DhaDylan/esp32c3-direction-finding/renders/pcb_bottom.png

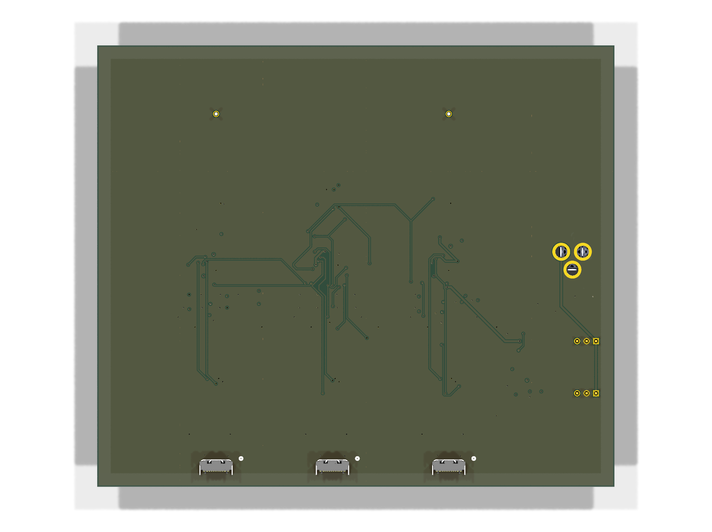
renders/pcb_bottom.png
