DhaDylan/esp32c3-direction-finding/renders/pcb_iso.png

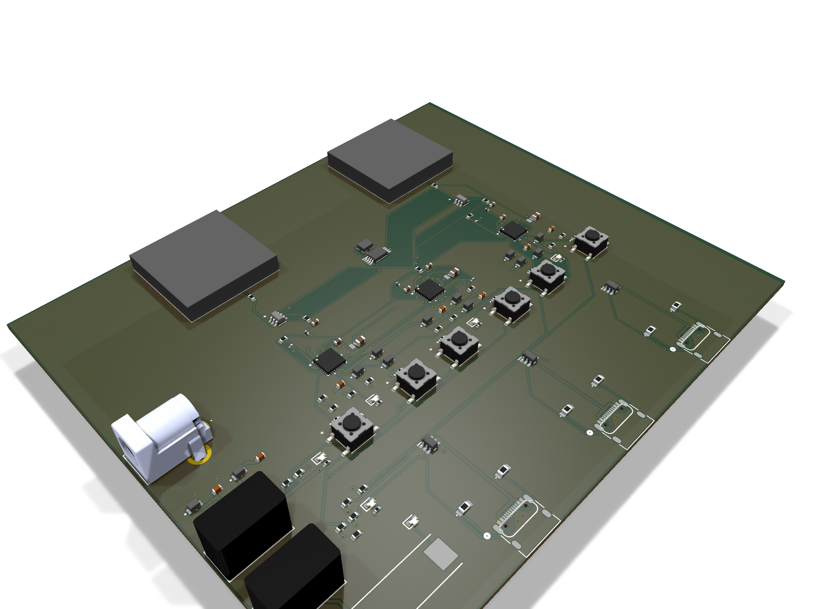
renders/pcb_iso.png
