DhaDylan/esp32c3-direction-finding/renders/pcb_top.png

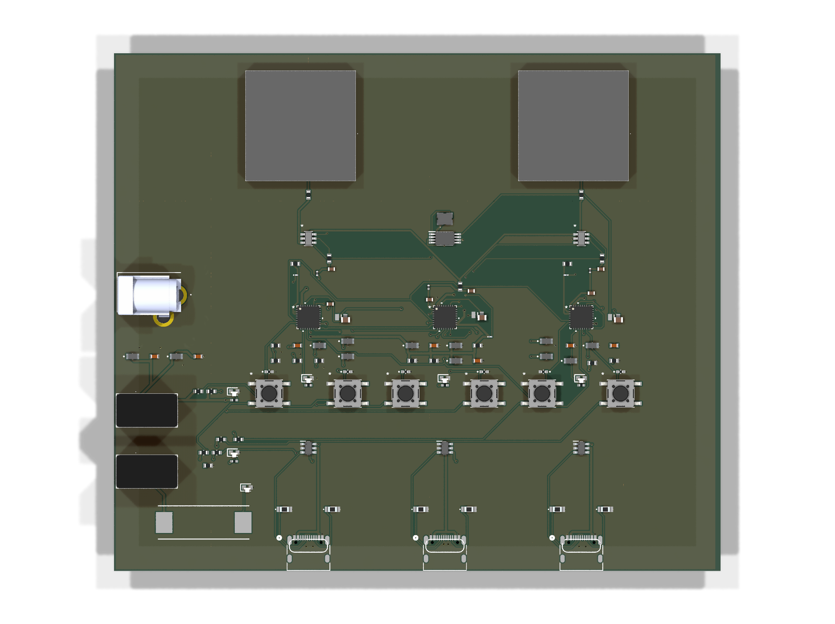
renders/pcb_top.png
