DhaDylan/esp32c3-direction-finding/renders/proto2x4_iso.png

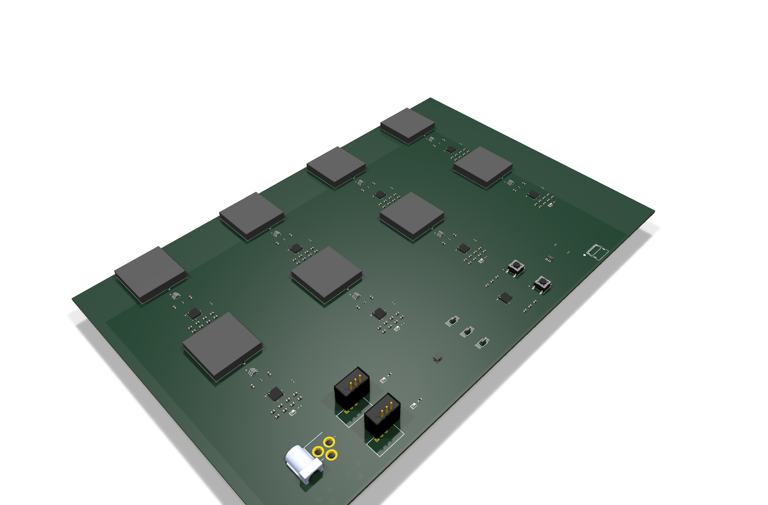
renders/proto2x4_iso.png
