DhaDylan/esp32c3-direction-finding/renders/proto2x4_top.png

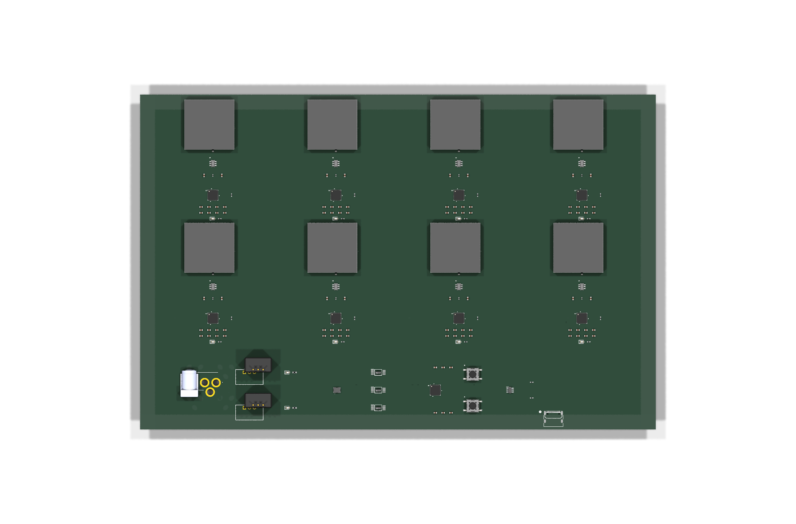
renders/proto2x4_top.png
