DhaDylan/esp32c3-direction-finding/3dmodels/3dmodels/generic_R_0402_1005Metric.stp

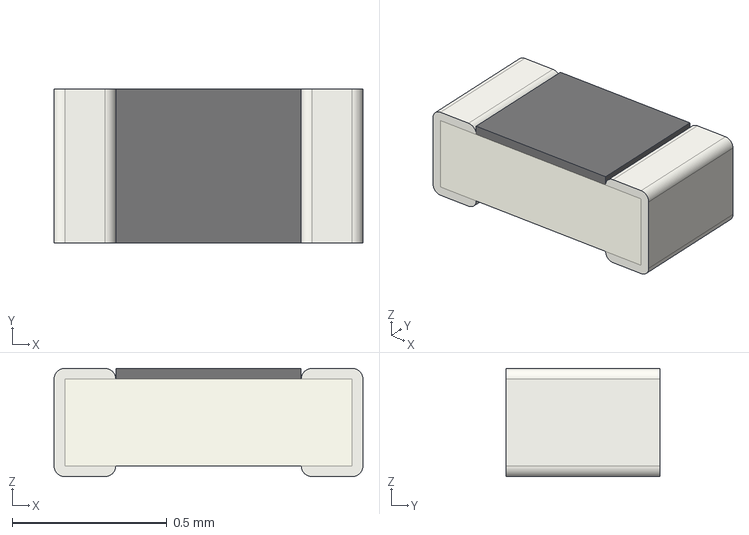
[picture p7: CAD file, 2026-08-13]
3dmodels/3dmodels/generic_R_0402_1005Metric.stp
1.00 x 0.5 x 0.35 mm
