DhaDylan/esp32c3-direction-finding/3dmodels/3dmodels/MHQ0402PSA2N0ST000.stp

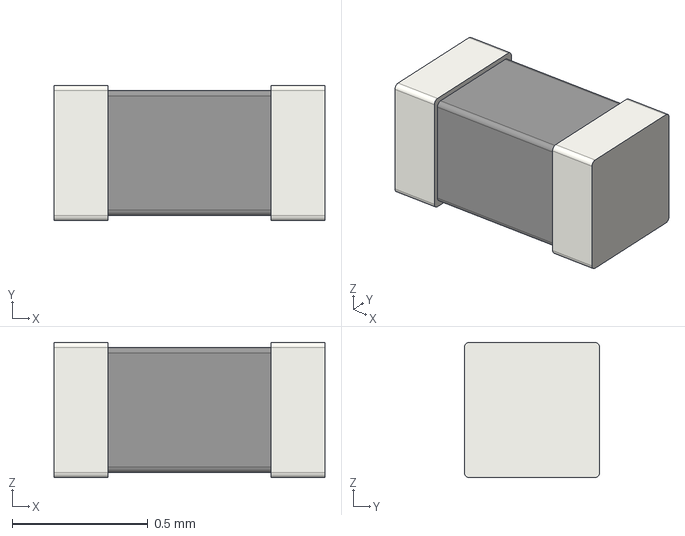
[picture p8: CAD file, 2026-08-13]
3dmodels/3dmodels/MHQ0402PSA2N0ST000.stp
1.00 x 0.5 x 0.5 mm
