DhaDylan/esp32c3-direction-finding/3dmodels/3dmodels/generic_SW_PTS645.stp

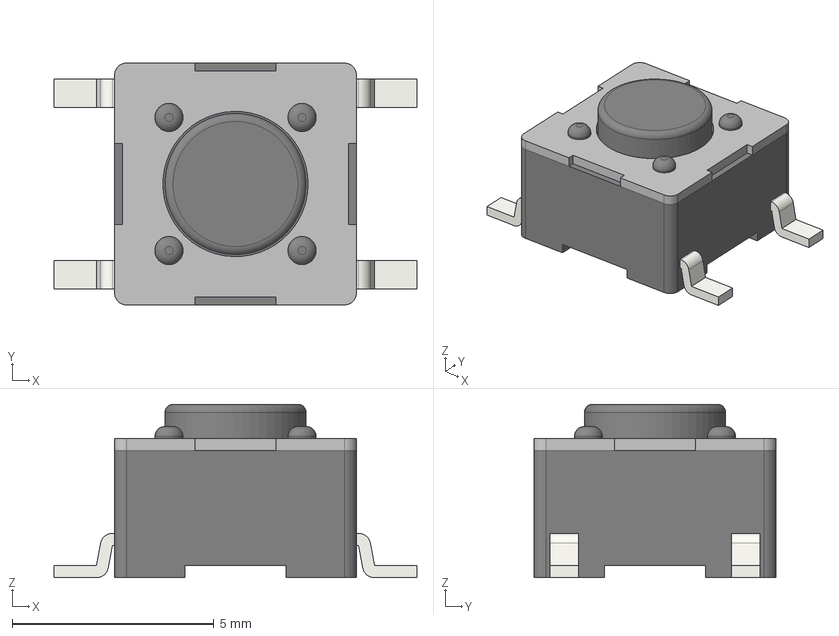
[picture p9: CAD file, 2026-08-13]
3dmodels/3dmodels/generic_SW_PTS645.stp
9.00 x 6.00 x 4.30 mm
