DhaDylan/esp32c3-direction-finding/3dmodels/3dmodels/generic_C_0603_1608Metric.stp

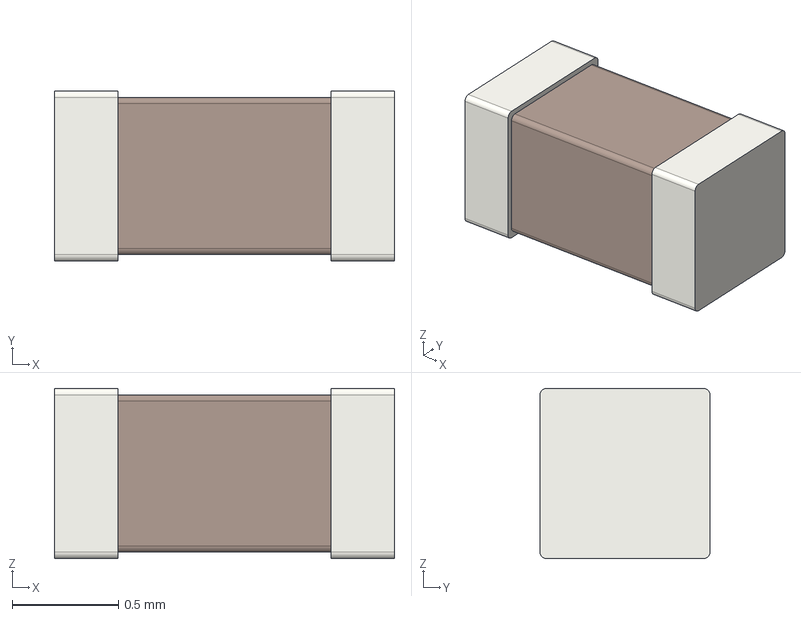
[picture p10: CAD file, 2026-08-13]
3dmodels/3dmodels/generic_C_0603_1608Metric.stp
1.60 x 0.8 x 0.8 mm
