DhaDylan/esp32c3-direction-finding/3dmodels/3dmodels/generic_QFN32_5x5mm.stp

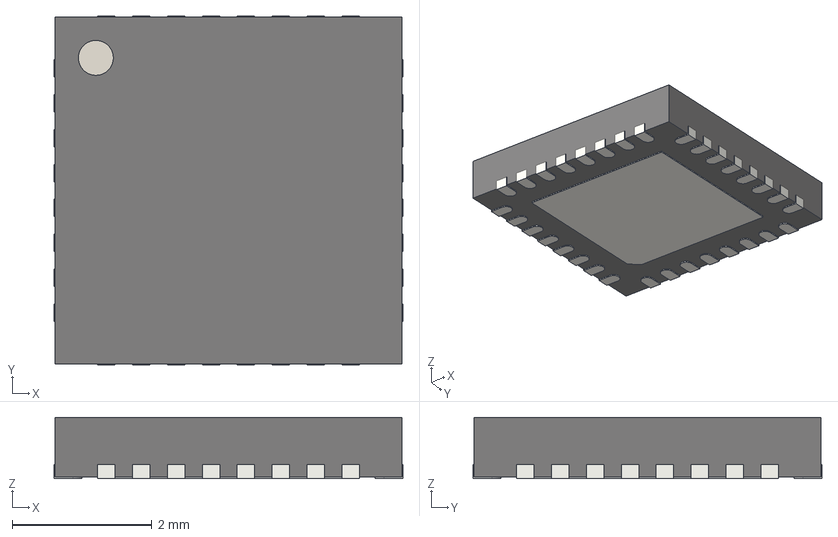
[picture p11: CAD file, 2026-08-13]
3dmodels/3dmodels/generic_QFN32_5x5mm.stp
5.00 x 5.00 x 0.875 mm
