DhaDylan/esp32c3-direction-finding/3dmodels/3dmodels/LTST-C190GKT.stp

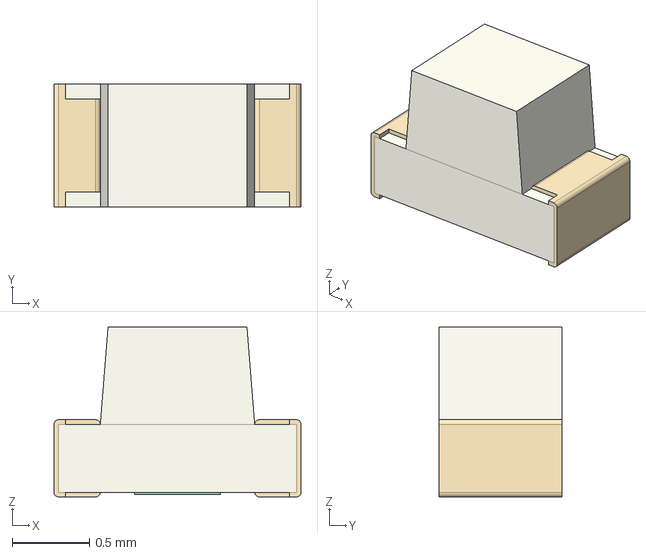
[picture p12: CAD file, 2026-08-13]
3dmodels/3dmodels/LTST-C190GKT.stp
1.60 x 0.8 x 1.10 mm
