DhaDylan/esp32c3-direction-finding/3dmodels/3dmodels/LM2936M-3.3_NOPB.stp

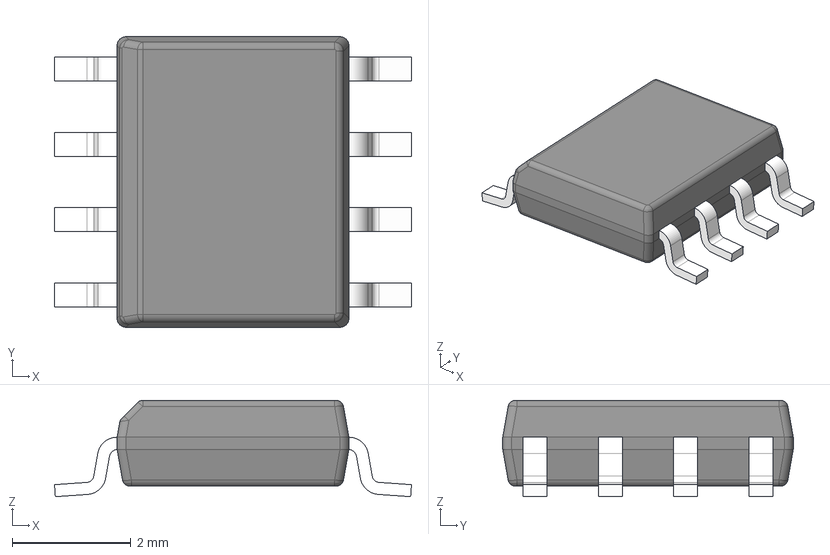
[picture p13: CAD file, 2026-08-12]
3dmodels/3dmodels/LM2936M-3.3_NOPB.stp
6.02 x 4.90 x 1.63 mm
BODY-SO
LEAD-D0008A x 8
