DhaDylan/esp32c3-direction-finding/3dmodels/3dmodels/USB4105-GF-A.stp

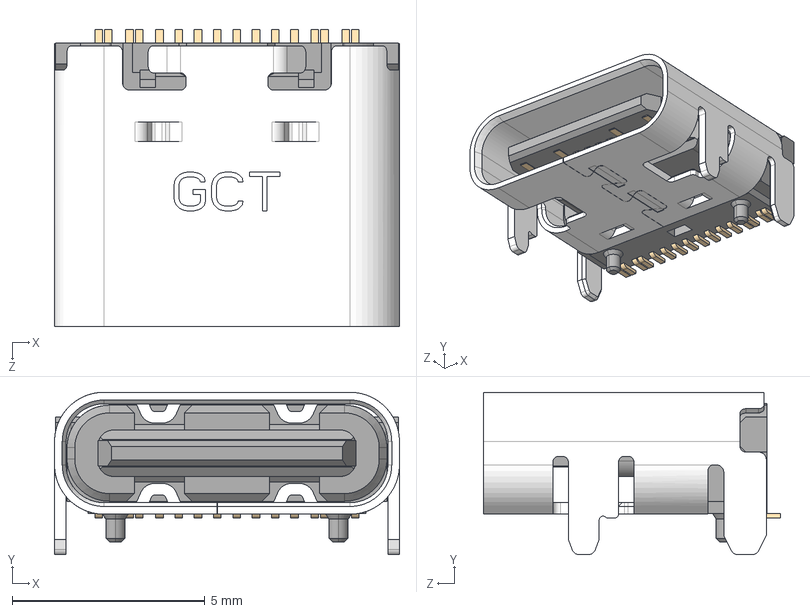
[picture p14: CAD file, 2026-08-12]
3dmodels/3dmodels/USB4105-GF-A.stp
8.94 x 4.21 x 7.70 mm
HSG_默认
