DhaDylan/esp32c3-direction-finding/3dmodels/3dmodels/ERJ-UP6D5101V.stp

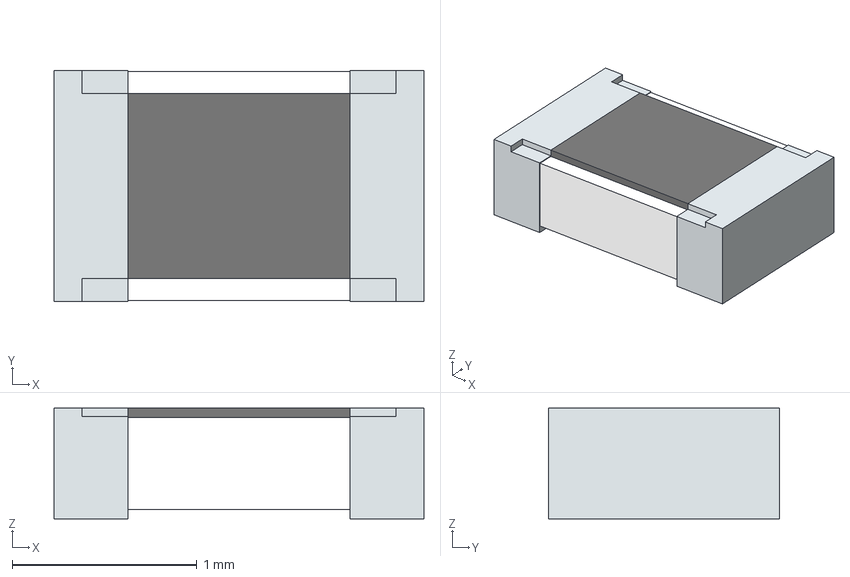
[picture p15: CAD file, 2026-08-12]
3dmodels/3dmodels/ERJ-UP6D5101V.stp
2.00 x 1.25 x 0.6 mm
solidBody
Terminal
solidTop
