DhaDylan/esp32c3-direction-finding/3dmodels/3dmodels/CGA3E3X7R1H105K080AB.stp

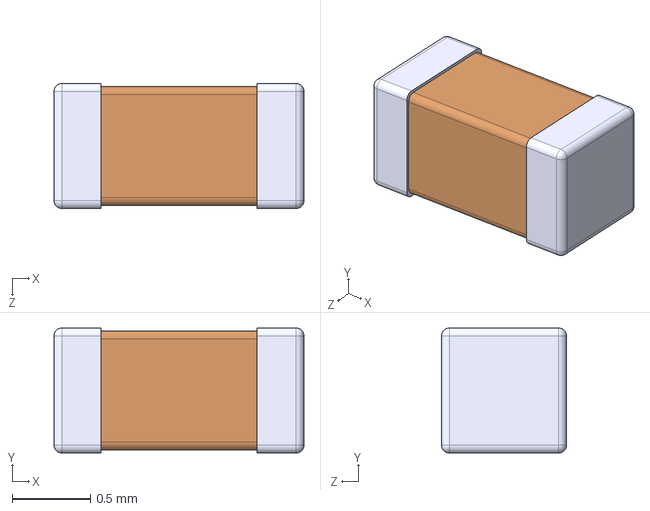
[picture p16: CAD file, 2026-08-12]
3dmodels/3dmodels/CGA3E3X7R1H105K080AB.stp
1.60 x 0.8 x 0.8 mm
