DhaDylan/esp32c3-direction-finding/3dmodels/3dmodels/0603YC103M4T2A.stp

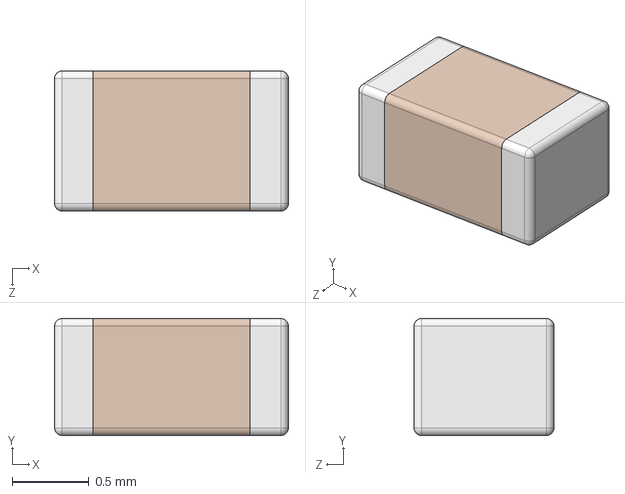
[picture p17: CAD file, 2026-08-12]
3dmodels/3dmodels/0603YC103M4T2A.stp
1.52 x 0.76 x 0.91 mm
