DhaDylan/esp32c3-direction-finding/3dmodels/3dmodels/RJ-6_ADI.step

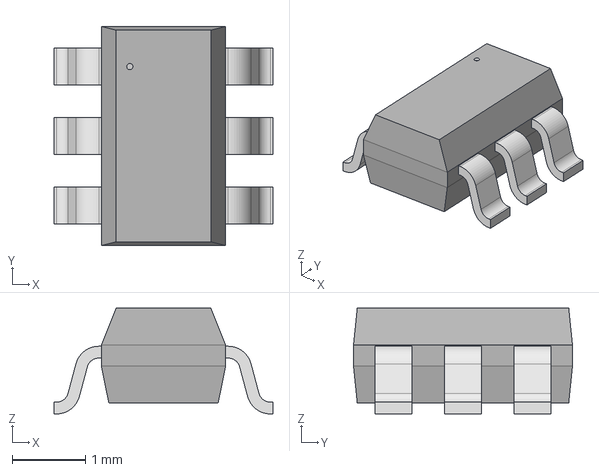
[picture p18: CAD file, 2026-08-12]
3dmodels/3dmodels/RJ-6_ADI.step
3.00 x 3.00 x 1.45 mm
