DhaDylan/esp32c3-direction-finding/3dmodels/3dmodels/USBLC6-2SC6.stp

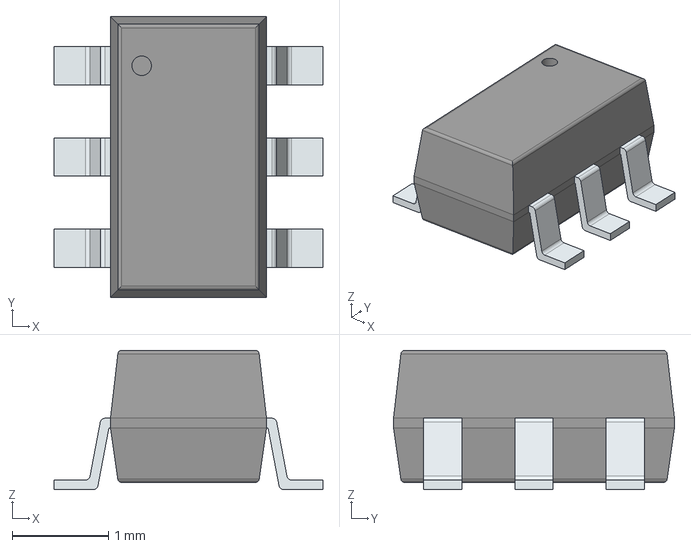
[picture p19: CAD file, 2026-08-12]
3dmodels/3dmodels/USBLC6-2SC6.stp
2.80 x 2.92 x 1.45 mm
PinsArrayLR
