DhaDylan/esp32c3-direction-finding/3dmodels/3dmodels/WDP.2458.25.4.B.02.stp

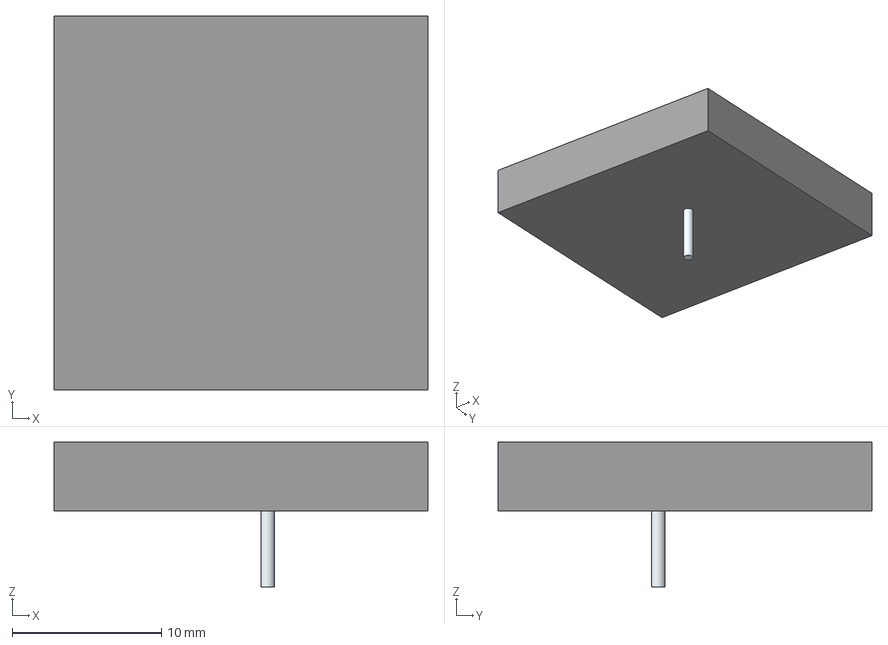
[picture p20: CAD file, 2026-08-12]
3dmodels/3dmodels/WDP.2458.25.4.B.02.stp
25.1 x 25.1 x 9.70 mm
Leads
