DhaDylan/esp32c3-direction-finding/3dmodels/3dmodels/TSR_2-2433N.stp

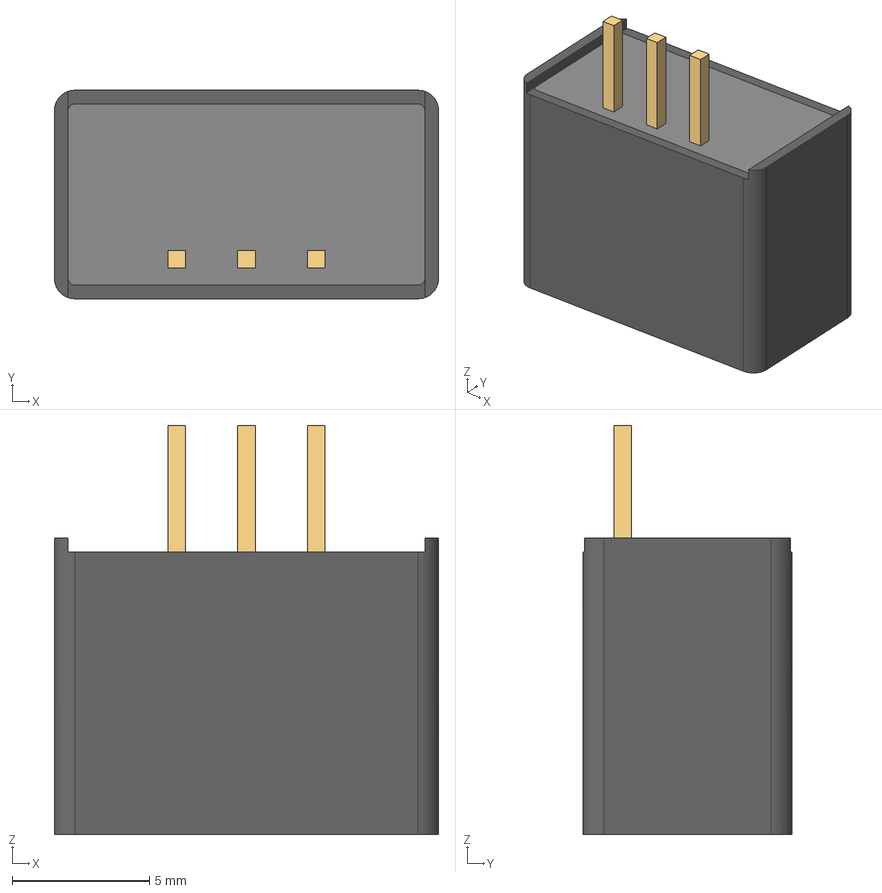
[picture p21: CAD file, 2026-08-12]
3dmodels/3dmodels/TSR_2-2433N.stp
14.0 x 7.60 x 14.9 mm
CASE-00
膠-00
PIN-00 x 3
