DhaDylan/esp32c3-direction-finding/3dmodels/3dmodels/ECE-A1CN100U.stp

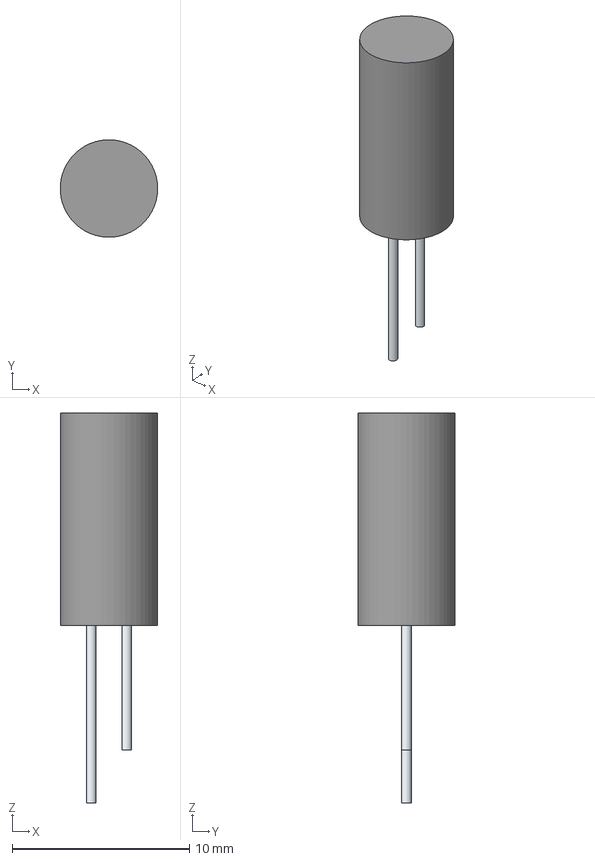
[picture p22: CAD file, 2026-08-12]
3dmodels/3dmodels/ECE-A1CN100U.stp
5.49 x 5.50 x 22.0 mm
SimpleBody
Pin1
Pin2
