DhaDylan/esp32c3-direction-finding/3dmodels/3dmodels/CDCLVC1103PW.stp

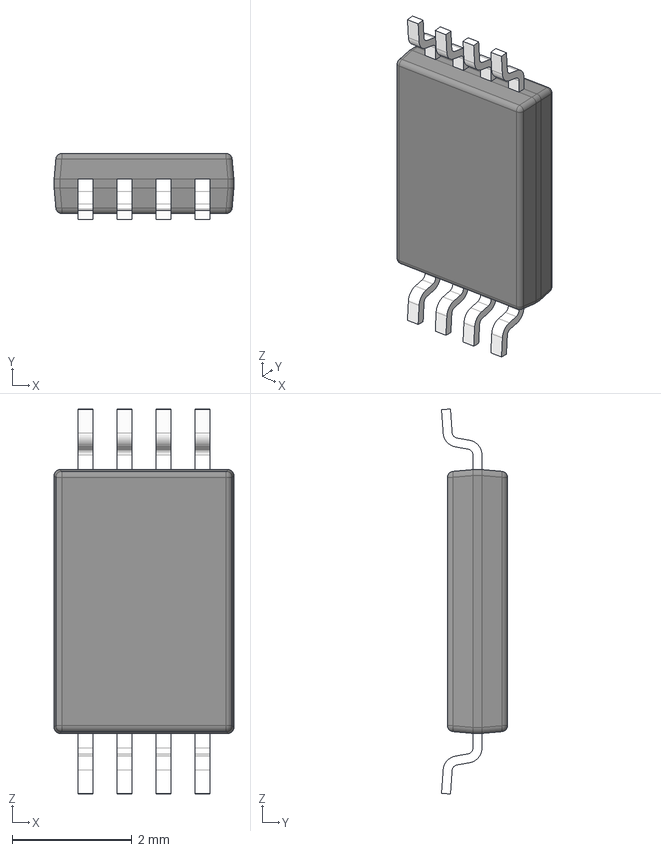
[picture p23: CAD file, 2026-08-12]
3dmodels/3dmodels/CDCLVC1103PW.stp
3.00 x 1.10 x 6.42 mm
BODY-SO
LEAD-SO x 8
PIN1-ID
