DhaDylan/esp32c3-direction-finding/3dmodels/3dmodels/MLG0603S2N0ST000.stp

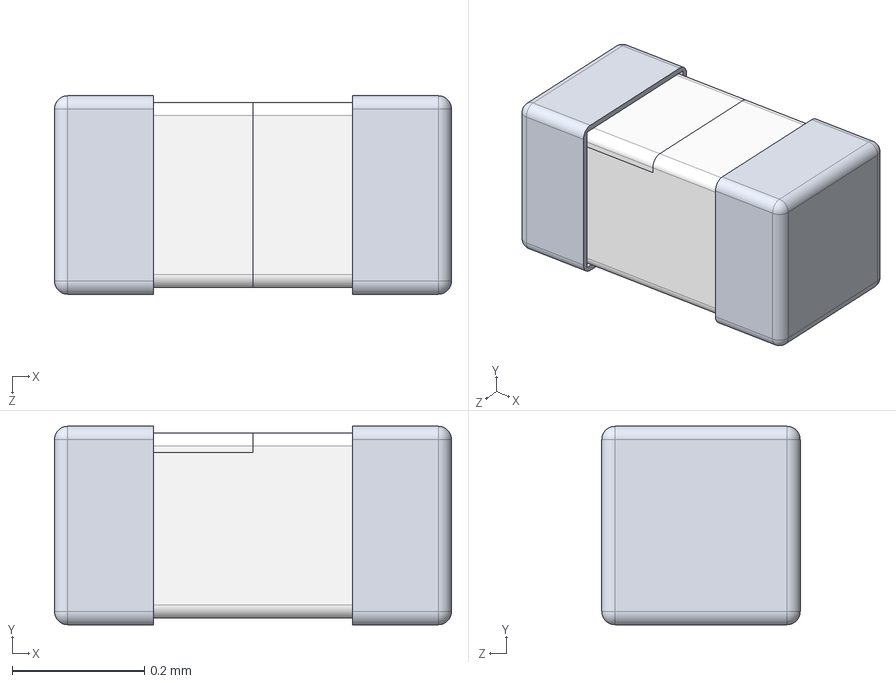
[picture p24: CAD file, 2026-08-12]
3dmodels/3dmodels/MLG0603S2N0ST000.stp
0.6 x 0.3 x 0.3 mm
