DhaDylan/esp32c3-direction-finding/3dmodels/3dmodels/RCLAMP0524S.TCT.stp

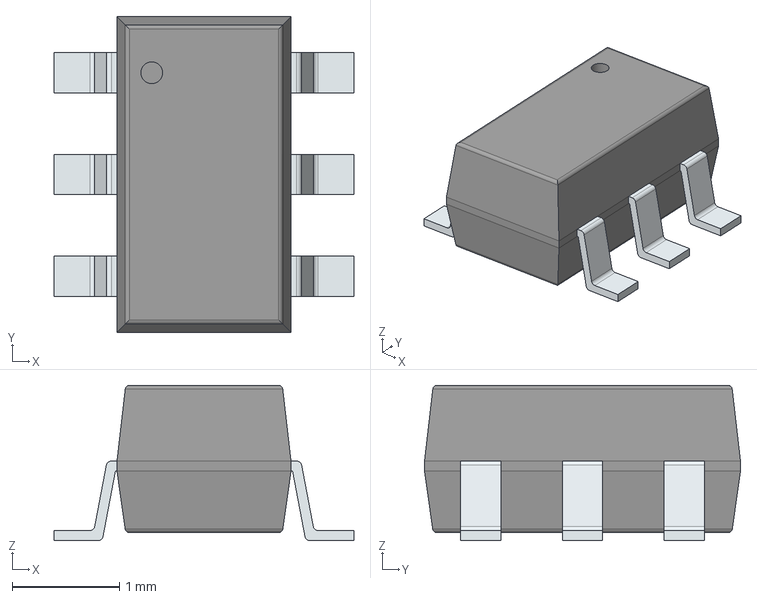
[picture p25: CAD file, 2026-08-12]
3dmodels/3dmodels/RCLAMP0524S.TCT.stp
2.80 x 2.95 x 1.45 mm
PinsArrayLR
