DhaDylan/esp32c3-direction-finding/3dmodels/3dmodels/MP2307DN-LF-Z.stp

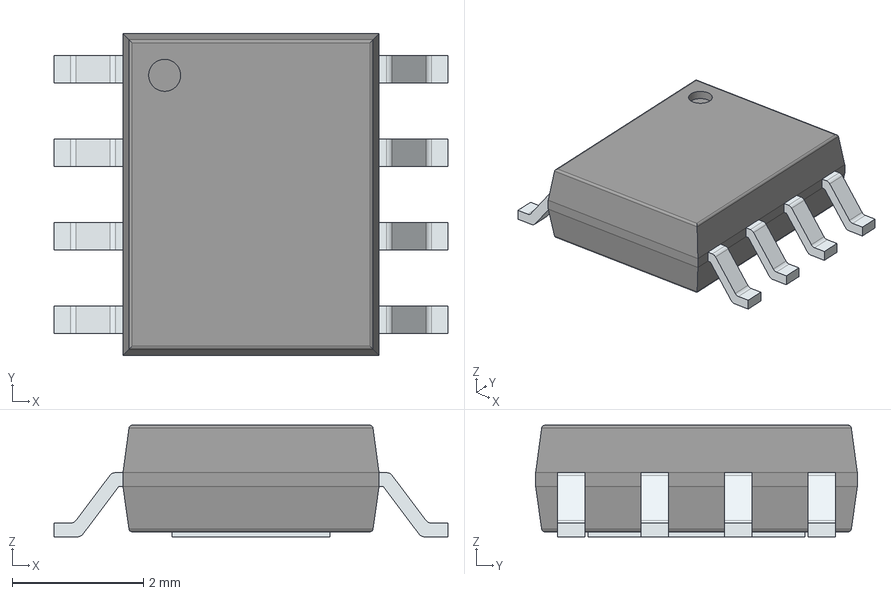
[picture p26: CAD file, 2026-08-12]
3dmodels/3dmodels/MP2307DN-LF-Z.stp
6.00 x 4.90 x 1.70 mm
PinsArrayLR
ThermalPad
