DhaDylan/esp32c3-direction-finding/3dmodels/3dmodels/LT1763IDE-3.3#PBF.stp

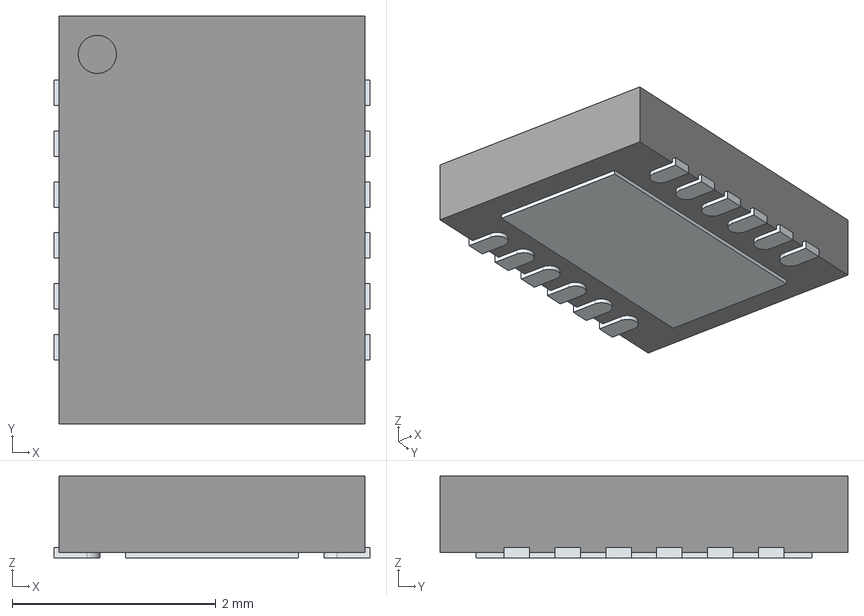
[picture p27: CAD file, 2026-08-12]
3dmodels/3dmodels/LT1763IDE-3.3#PBF.stp
3.10 x 4.00 x 0.8 mm
ThermalPin
PinsArrayLR
