DhaDylan/esp32c3-direction-finding/3dmodels/3dmodels/C1608X7T1A106M080AC.stp

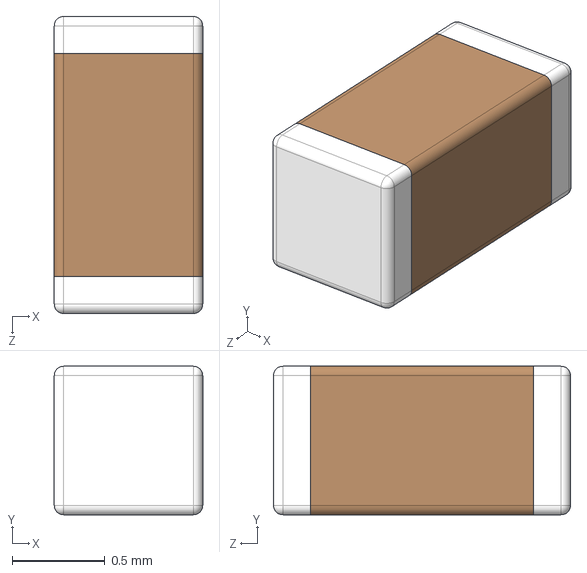
[picture p28: CAD file, 2026-08-12]
3dmodels/3dmodels/C1608X7T1A106M080AC.stp
0.8 x 0.8 x 1.60 mm
