DhaDylan/esp32c3-direction-finding/3dmodels/3dmodels/MBASQ21GAB7104MTCA01.stp

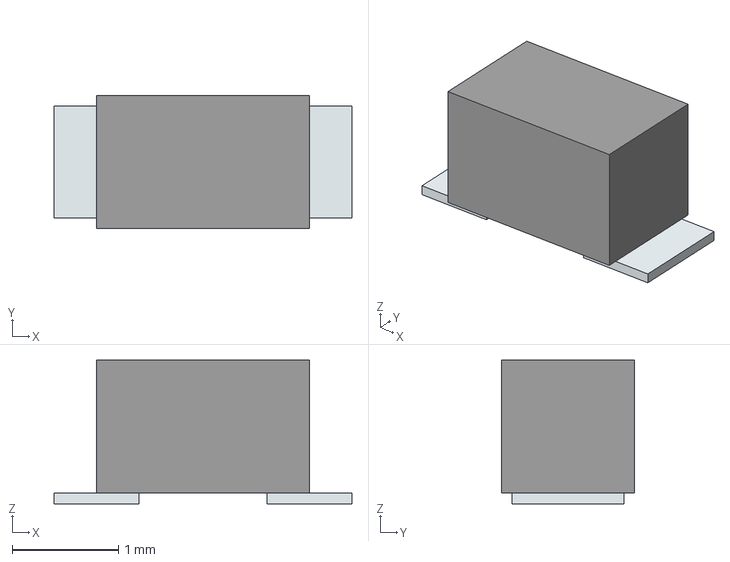
[picture p29: CAD file, 2026-08-12]
3dmodels/3dmodels/MBASQ21GAB7104MTCA01.stp
2.80 x 1.25 x 1.35 mm
Pins
