DhaDylan/esp32c3-direction-finding/3dmodels/3dmodels/ABM14N-40.0000MHZ-8-N1U.stp

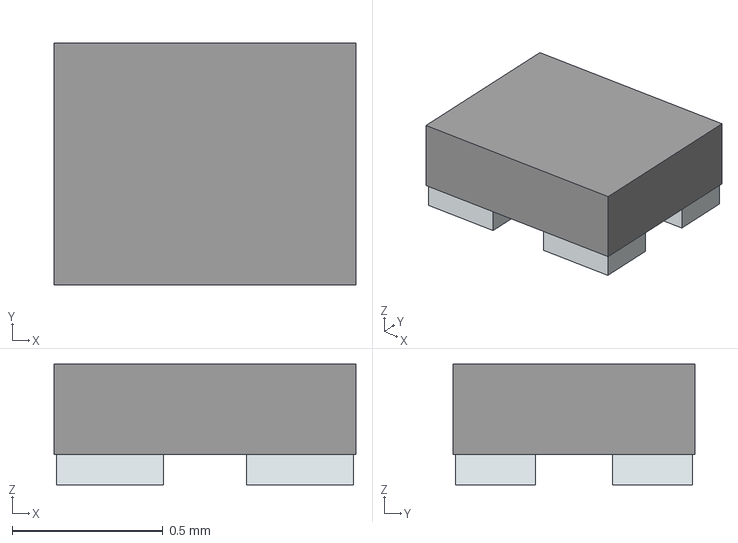
[picture p30: CAD file, 2026-08-12]
3dmodels/3dmodels/ABM14N-40.0000MHZ-8-N1U.stp
1.00 x 0.8 x 0.4 mm
Pins
