DhaDylan/esp32c3-direction-finding/3dmodels/3dmodels/MP2329CGG-Z.stp

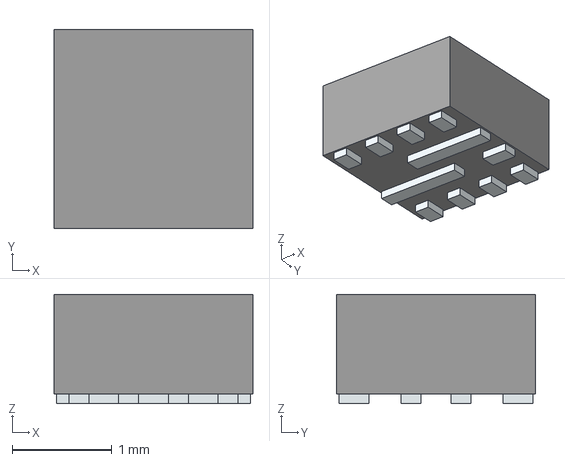
[picture p31: CAD file, 2026-08-12]
3dmodels/3dmodels/MP2329CGG-Z.stp
2.00 x 2.00 x 1.10 mm
Pins
