DhaDylan/esp32c3-direction-finding/(list of files, cad)

Other CAD files:
3dmodels/3dmodels/430182043816.stp
3dmodels/3dmodels/694106301002.stp
3dmodels/3dmodels/FK4000032.stp
3dmodels/3dmodels/MCU08050C2209FP500.stp
3dmodels/3dmodels/RCC04021K50FKED.stp
