DhaDylan/esp32c3-direction-finding/(list of files, drawings)

Other design files:
pcb/board.dsn
pcb/board_rs.dsn
pcb/board_sym2.dsn
pcb/board_v4.dsn
pcb/board_v4b.dsn
pcb/board_v5.dsn
