DhaDylan/esp32c3-direction-finding/pcb/10.28.25 V2 Wifi PCB.kicad_pcb

## KiCad design pcb/10.28.25 V2 Wifi PCB.kicad_pcb (2026-08-13)

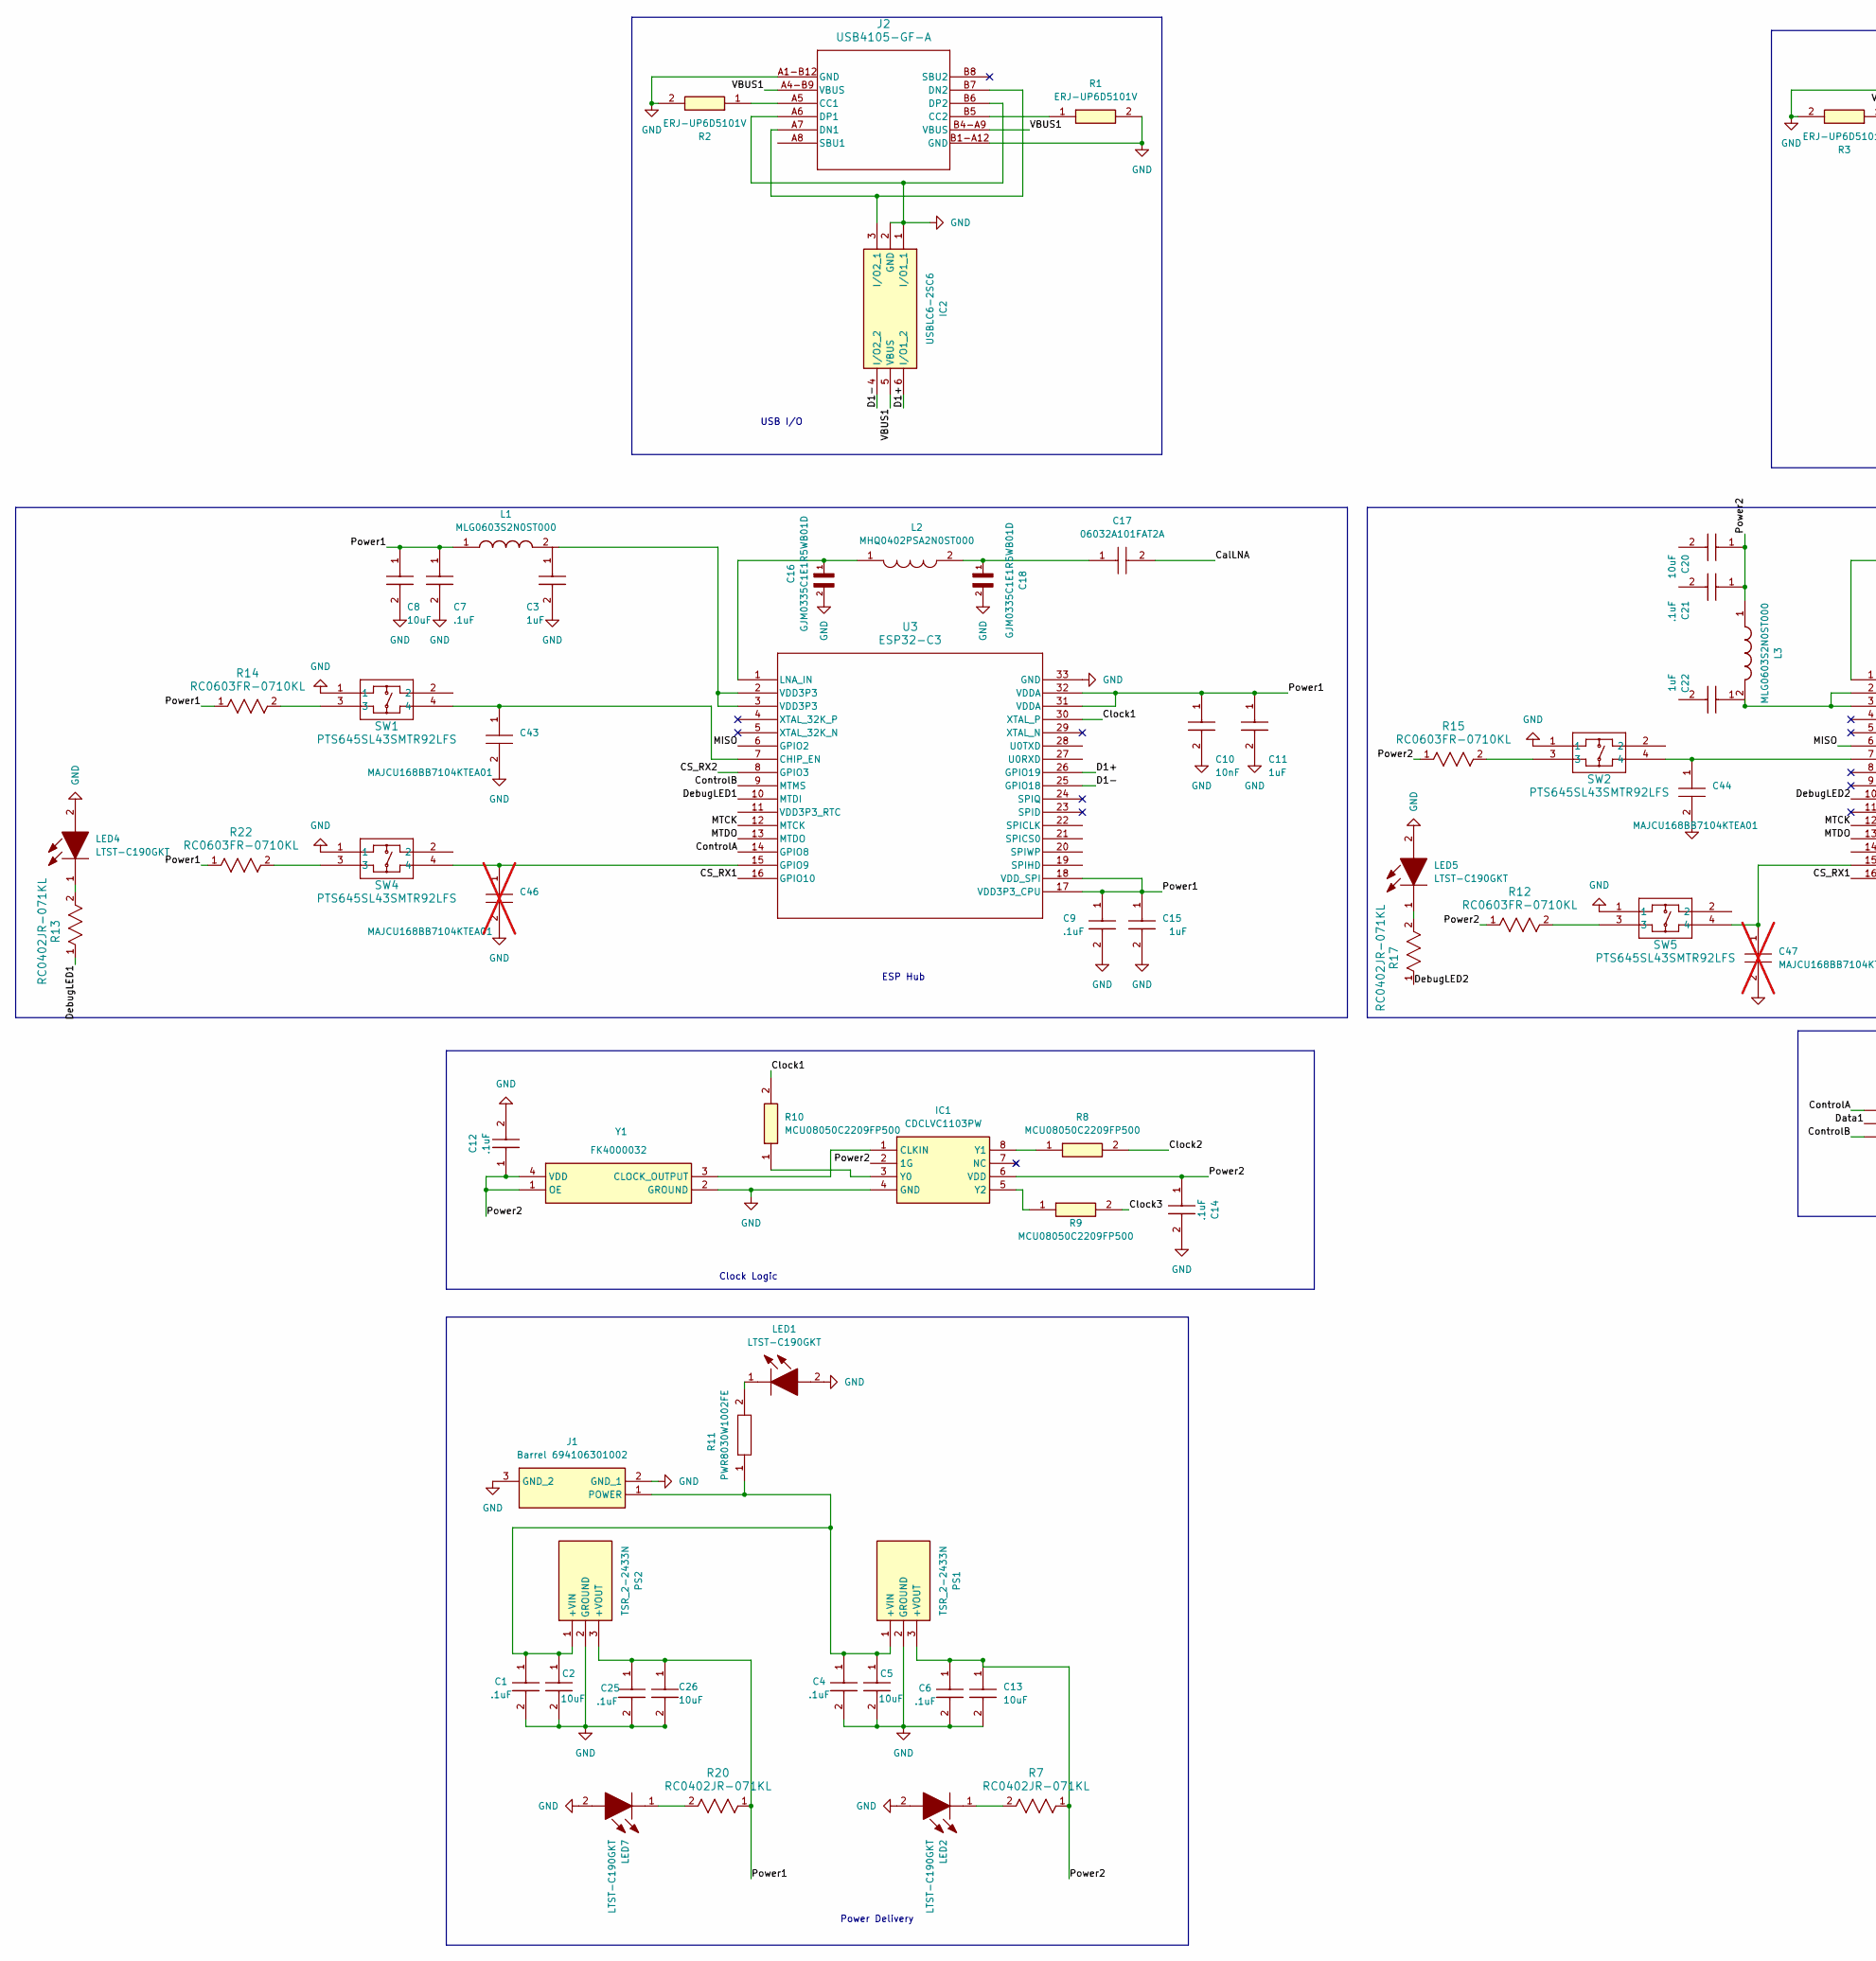
[picture p32: schematic 10.28.25 V2 Wifi PCB.kicad_sch, part in row 1, column 1]

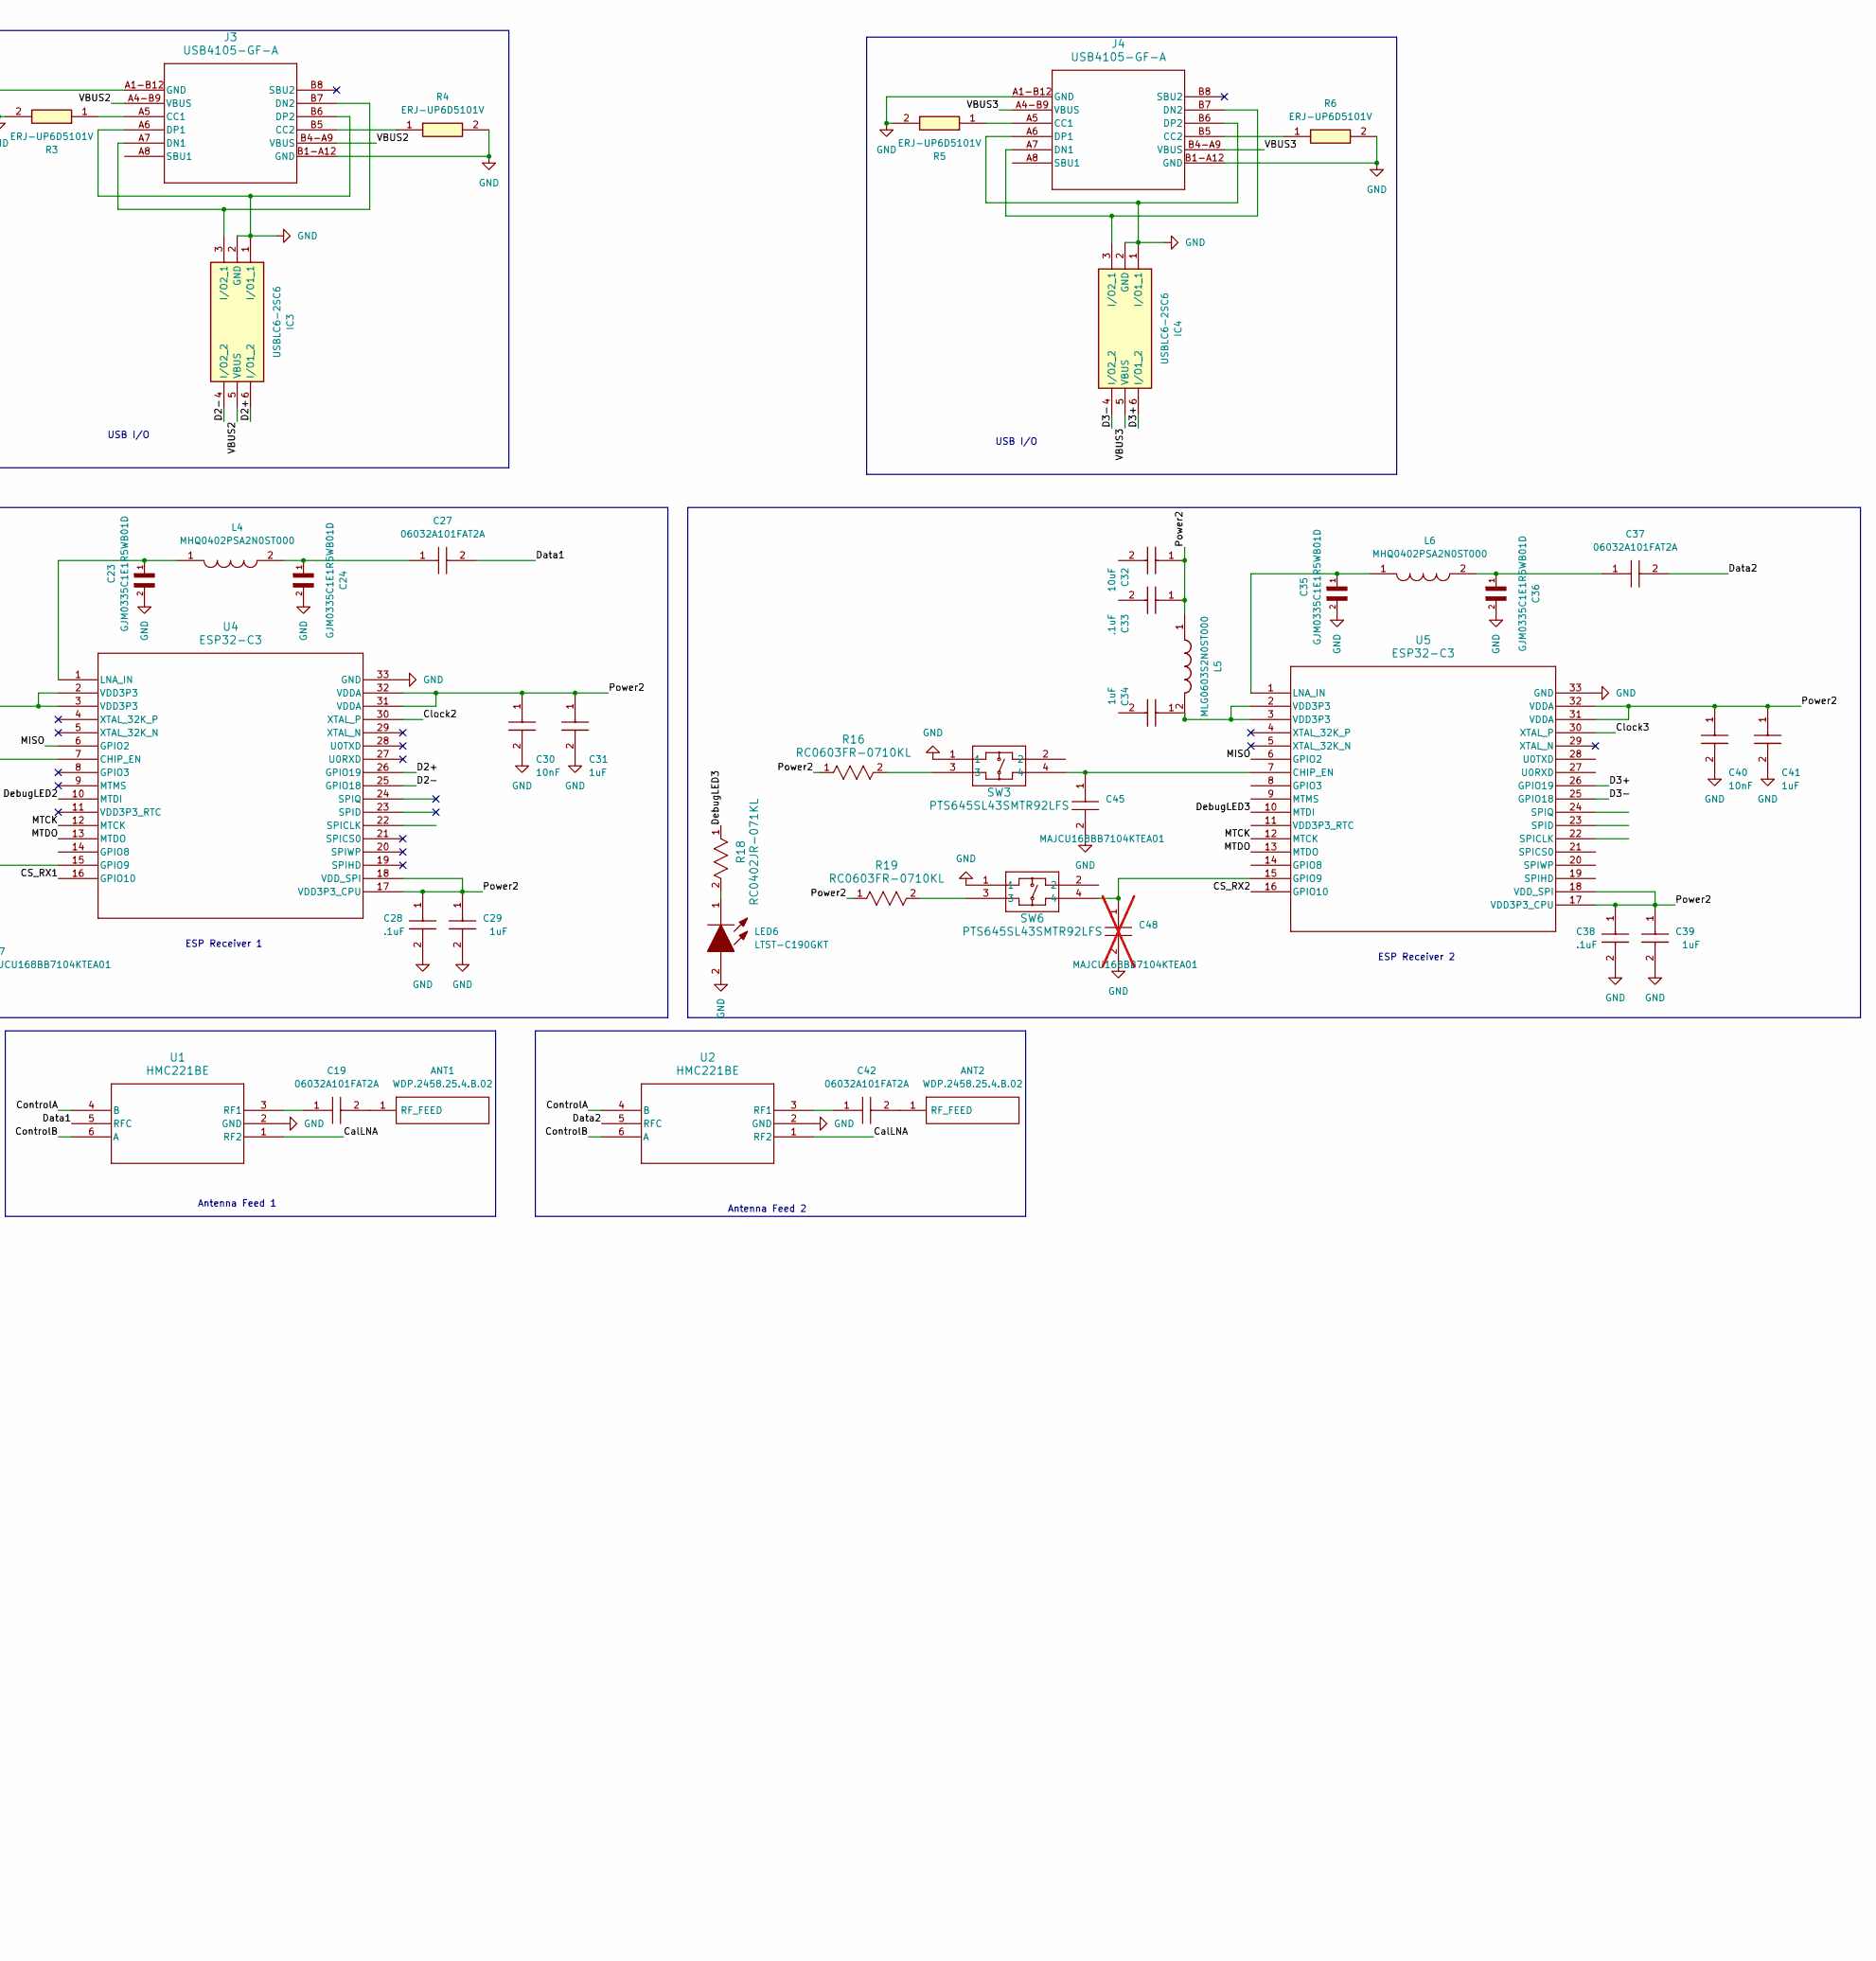
[picture p33: schematic 10.28.25 V2 Wifi PCB.kicad_sch, part in row 1, column 2]

Parts:
ANT1, ANT2: WDP.2458.25.4.B.02; WDP2458254B02; Mouser Part Number 960-WDP.2458.25.4B02
C1, C4, C6, C7, C9, C12, C14, C21, C25, C28, C33, C38: .1uF; MBASx21x; Manufacturer_Part_Number MBASQ21GAB7104MTCA01
C2, C5, C8, C13, C20, C26, C32: 10uF; CAPC1608X80N; Mouser Part Number 810-C1608X7T1A106M08
C3, C11, C15, C22, C29, C31, C34, C39, C41: 1uF; CAPC1608X90N; Manufacturer_Part_Number CGA3E3X7R1H105K080AB
C10, C30, C40: 10nF; CAPC1608X90N; Mouser Part Number 581-0603YC103M4T2A
C16, C18, C23, C24, C35, C36: GJM0335C1E1R5WB01D; CAPC0603X33N
C17, C19, C27, C37, C42: 06032A101FAT2A; CAPC1608X90N; Mouser Part Number 581-06032A101FAT2A
C43, C44, C45: MAJCU168BB7104KTEA01; MAJx16; Manufacturer_Part_Number MAJCU168BB7104KTEA01
C46, C47, C48: MAJCU168BB7104KTEA01; MAJx16; Manufacturer_Part_Number MAJCU168BB7104KTEA01; not fitted
IC1: CDCLVC1103PW; SOP65P640X120-8N; Mouser Part Number 595-CDCLVC1103PW
IC2, IC3, IC4: USBLC6-2SC6; SOT95P280X145-6N; Mouser Part Number 511-USBLC6-2SC6
J1: Barrel 694106301002; 694106301002_1; Mouser Part Number 710-694106301002
J2, J3, J4: USB4105-GF-A; USB4105_GCT
L1, L3, L5: MLG0603S2N0ST000; MLG0603S; Manufacturer_Part_Number MLG0603S2N0ST000
L2, L4, L6: MHQ0402PSA2N0ST000; INDC0402X26N; Mouser Part Number 810-MHQ0402PSA2N0ST0
LED1, LED2, LED4, LED5, LED6, LED7: LTST-C190GKT; LEDC1608X90N; Mouser Part Number 859-LTST-C190GKT
PS1, PS2: TSR_2-2433N; TSR22433N; Manufacturer_Part_Number TSR 2-2433N
R1, R2, R3, R4, R5, R6: ERJ-UP6D5101V; ERJUP6; Mouser Part Number 667-ERJ-UP6D5101V
R7, R13, R17, R18, R20: RC0402JR-071KL; RC0402N_YAG
R8, R9, R10: MCU08050C2209FP500; RESC2012X55N; Mouser Part Number 594-MCU08050C2209FP5
R11: PWR8030W1002FE; RESM20876X785N; Mouser Part Number 652-PWR8030W1002FE
R12, R14, R15, R16, R19, R22: RC0603FR-0710KL; RC0603N_YAG
SW1, SW2, SW3, SW4, SW5, SW6: PTS645SL43SMTR92LFS; PTS645SL43SMTR92LFS_CNK
U1, U2: HMC221BE; RJ-6_ADI
U3, U4, U5: ESP32-C3; QFN32_5X5_EXP
Y1: FK4000032; Mouser Part Number 729-FK4000032

Connections:
/CS_RX1: U3.16 (GPIO10), U4.16 (GPIO10)
/CS_RX2: U3.8 (GPIO3), U5.16 (GPIO10)
/CalLNA: C17.2, U1.1 (RF2), U2.1 (RF2)
/Clock1: R10.2, U3.30 (XTAL_P)
/Clock2: R8.2, U4.30 (XTAL_P)
/Clock3: R9.2, U5.30 (XTAL_P)
/ControlA: U1.4 (B), U2.4 (B), U3.14 (GPIO8)
/ControlB: U1.6 (A), U2.6 (A), U3.9 (MTMS)
/D1+: IC2.6 (I/O1_2), U3.26 (GPIO19)
/D1-: IC2.4 (I/O2_2), U3.25 (GPIO18)
/D2+: IC3.6 (I/O1_2), U4.26 (GPIO19)
/D2-: IC3.4 (I/O2_2), U4.25 (GPIO18)
/D3+: IC4.6 (I/O1_2), U5.26 (GPIO19)
/D3-: IC4.4 (I/O2_2), U5.25 (GPIO18)
/Data1: C27.2, U1.5 (RFC)
/Data2: C37.2, U2.5 (RFC)
/DebugLED1: R13.1, U3.10 (MTDI)
/DebugLED2: R17.1, U4.10 (MTDI)
/DebugLED3: R18.1, U5.10 (MTDI)
/MISO: U3.6 (GPIO2), U4.6 (GPIO2), U5.6 (GPIO2)
/MTCK: U3.12 (MTCK), U4.12 (MTCK), U5.12 (MTCK)
/MTDO: U3.13 (MTDO), U4.13 (MTDO), U5.13 (MTDO)
/Power1: C7.1, C8.1, C9.1, C10.1, C11.1, C15.1, C25.1, C26.1, L1.1, PS2.3 (+VOUT), R14.1, R20.1, R22.1, U3.17 (VDD3P3_CPU), U3.18 (VDD_SPI), U3.31 (VDDA), U3.32 (VDDA)
/Power2: C6.1, C12.1, C13.1, C14.1, C20.1, C21.1, C28.1, C29.1, C30.1, C31.1, C32.1, C33.1, C38.1, C39.1, C40.1, C41.1, IC1.2 (1G), IC1.6 (VDD), L3.1, L5.1, PS1.3 (+VOUT), R7.1, R12.1, R15.1, R16.1, R19.1, U4.17 (VDD3P3_CPU), U4.18 (VDD_SPI), U4.31 (VDDA), U4.32 (VDDA), U5.17 (VDD3P3_CPU), U5.18 (VDD_SPI), U5.31 (VDDA), U5.32 (VDDA), Y1.1 (OE), Y1.4 (VDD)
/VBUS1: IC2.5 (VBUS), J2.A4-B9 (VBUS), J2.B4-A9 (VBUS)
/VBUS2: IC3.5 (VBUS), J3.A4-B9 (VBUS), J3.B4-A9 (VBUS)
/VBUS3: IC4.5 (VBUS), J4.A4-B9 (VBUS), J4.B4-A9 (VBUS)
GND: C1.2, C2.2, C3.2, C4.2, C5.2, C6.2, C7.2, C8.2, C9.2, C10.2, C11.2, C12.2, C13.2, C14.2, C15.2, C16.2, C18.2, C23.2, C24.2, C25.2, C26.2, C28.2, C29.2, C30.2, C31.2, C35.2, C36.2, C38.2, C39.2, C40.2, C41.2, C43.2, C44.2, C45.2, C46.2, C47.2, C48.2, IC1.4 (GND), IC2.1 (I/O1_1), IC2.2 (GND), IC3.1 (I/O1_1), IC3.2 (GND), IC4.1 (I/O1_1), IC4.2 (GND), J1.2 (GND_1), J1.3 (GND_2), J2.A1-B12 (GND), J2.A6 (DP1), J2.B1-A12 (GND), J2.B6 (DP2), J3.A1-B12 (GND), J3.A6 (DP1), J3.B1-A12 (GND), J3.B6 (DP2), J4.A1-B12 (GND), J4.A6 (DP1), J4.B1-A12 (GND), J4.B6 (DP2), LED1.2, LED2.2, LED4.2, LED5.2, LED6.2, LED7.2, PS1.2 (GROUND), PS2.2 (GROUND), R1.2, R2.2, R3.2, R4.2, R5.2, R6.2, SW1.1, SW2.1, SW3.1, SW4.1, SW5.1, SW6.1, U1.2 (GND), U2.2 (GND), U3.33 (GND), U4.33 (GND), U5.33 (GND), Y1.2 (GROUND)
unnamed: ANT1.1 (RF_FEED), C19.2
unnamed: ANT2.1 (RF_FEED), C42.2
unnamed: C17.1, C18.1, L2.2
unnamed: C22.1, L3.2, U4.2 (VDD3P3), U4.3 (VDD3P3)
unnamed: C24.1, C27.1, L4.2
unnamed: C34.1, L5.2, U5.2 (VDD3P3), U5.3 (VDD3P3)
unnamed: C36.1, C37.1, L6.2
unnamed: IC1.1 (CLKIN), Y1.3 (CLOCK_OUTPUT)
unnamed: IC1.3 (Y0), R10.1
unnamed: IC1.8 (Y1), R8.1
unnamed: IC1.5 (Y2), R9.1
unnamed: IC2.3 (I/O2_1), J2.A7 (DN1), J2.B7 (DN2)
unnamed: IC3.3 (I/O2_1), J3.A7 (DN1), J3.B7 (DN2)
unnamed: IC4.3 (I/O2_1), J4.A7 (DN1), J4.B7 (DN2)
unnamed: C1.1, C2.1, C4.1, C5.1, J1.1 (POWER), PS1.1 (+VIN), PS2.1 (+VIN), R11.1
unnamed: J2.A5 (CC1), R2.1
unnamed: J2.B5 (CC2), R1.1
unnamed: J3.A5 (CC1), R3.1
unnamed: J3.B5 (CC2), R4.1
unnamed: J4.A5 (CC1), R5.1
unnamed: J4.B5 (CC2), R6.1
unnamed: L1.2, U3.2 (VDD3P3), U3.3 (VDD3P3)
unnamed: LED1.1, R11.2
unnamed: LED2.1, R7.2
unnamed: LED4.1, R13.2
unnamed: LED5.1, R17.2
unnamed: LED6.1, R18.2
unnamed: LED7.1, R20.2
unnamed: R12.2, SW5.3
unnamed: R14.2, SW1.3
unnamed: R15.2, SW2.3
unnamed: R16.2, SW3.3
unnamed: R19.2, SW6.3
unnamed: R22.2, SW4.3
unnamed: C19.1, U1.3 (RF1)
unnamed: C42.1, U2.3 (RF1)
unnamed: C43.1, SW1.4, U3.7 (CHIP_EN)
unnamed: C46.1, SW4.4, U3.15 (GPIO9)
unnamed: C16.1, L2.1, U3.1 (LNA_IN)
unnamed: C44.1, SW2.4, U4.7 (CHIP_EN)
unnamed: C47.1, SW5.4, U4.15 (GPIO9)
unnamed: C23.1, L4.1, U4.1 (LNA_IN)
unnamed: C45.1, SW3.4, U5.7 (CHIP_EN)
unnamed: C48.1, SW6.4, U5.15 (GPIO9)
unnamed: C35.1, L6.1, U5.1 (LNA_IN)

Notes on the sheet:
Antenna Feed 1
USB I/O
Clock Logic
ESP Hub
Antenna Feed 2
ESP Receiver 2
ESP Receiver 1
Power Delivery

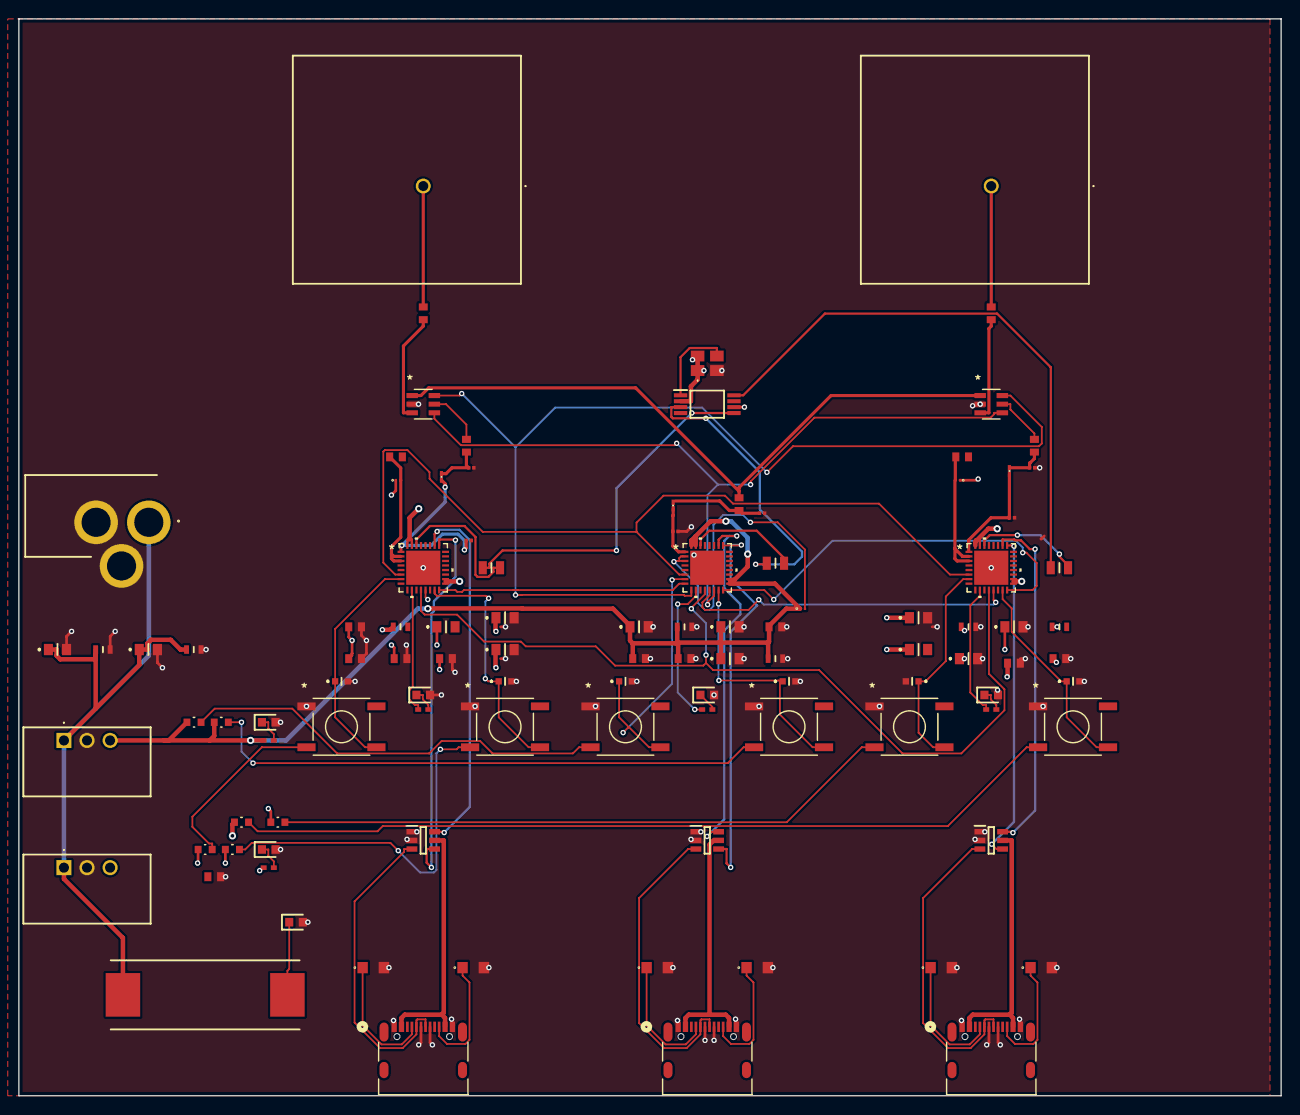
[picture p34: board 10.28.25 V2 Wifi PCB.kicad_pcb from above]

Board: 4 copper layers, 138.9 x 118.5 mm, 105 parts (0 on the bottom side), 73 nets.
