DhaDylan/esp32c3-direction-finding/PCB ONLY/PCB ONLY.kicad_pcb

## KiCad design PCB ONLY/PCB ONLY.kicad_pcb (2026-08-12)

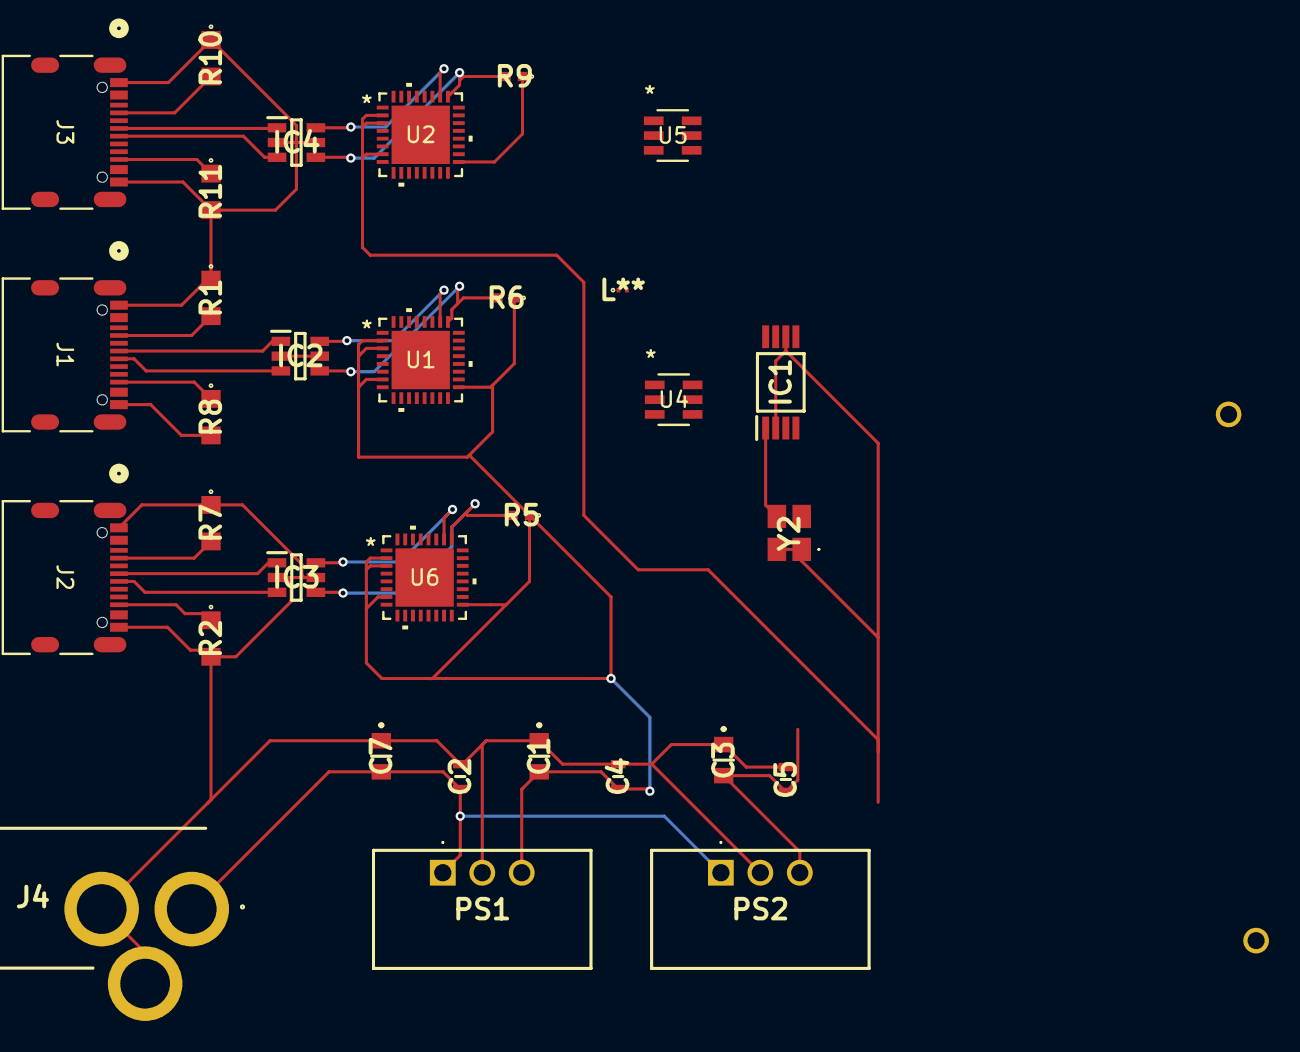
[picture p35: board PCB ONLY.kicad_pcb from above]

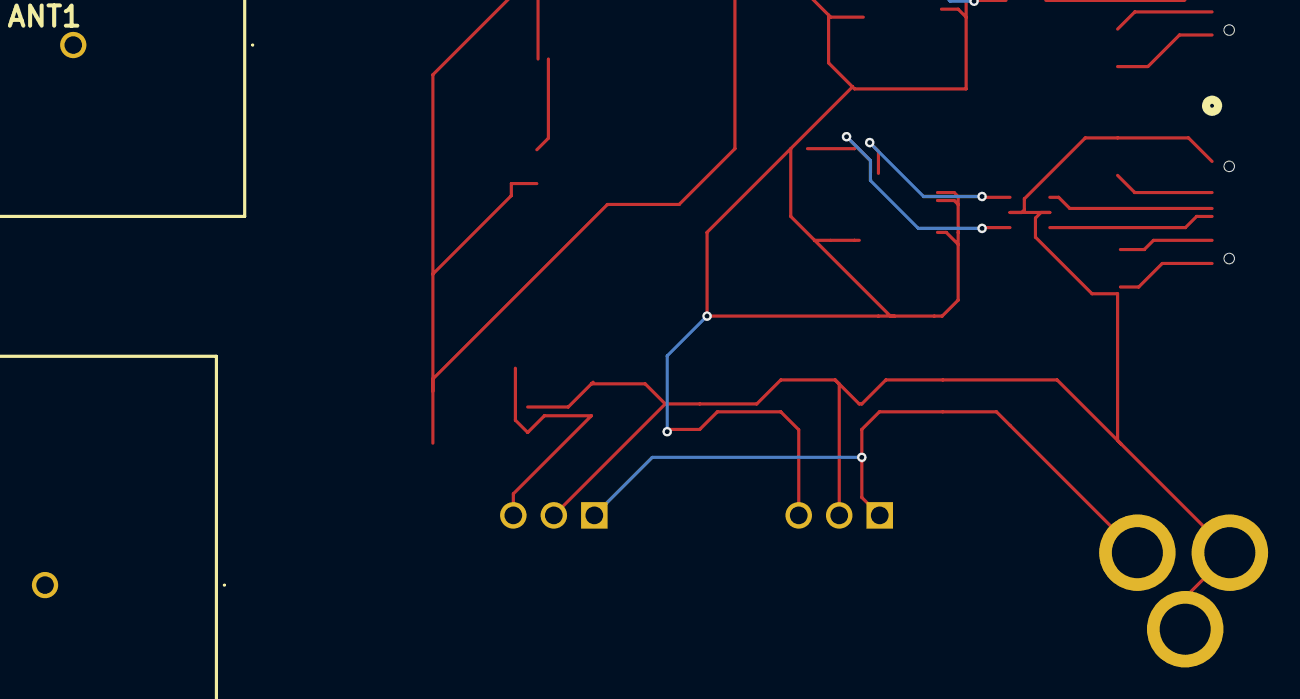
[picture p36: board PCB ONLY.kicad_pcb from below]

Board: 2 copper layers, 34 parts (2 on the bottom side), 33 nets.

Parts:
ANT1, ANT2: WDP.2458.25.4.B.02; WDP2458254B02
C1, C3, C7: .1uF; MBASx21x
C2, C4, C5: 10uF; CAPC1608X80N
IC1: CDCLVC1103PW Clk Buf; SOP65P640X120-8N
IC2, IC3, IC4: USBLC6-2SC6; SOT95P280X145-6N
J1, J2, J3: USB4105-GF-A; USB4105_GCT
J4: 694106301002 Barrel; 694106301002_1
L**: MLG0603S
PS1, PS2: TSR_2-2433N Buck; TSR22433N
R1, R2, R7, R8, R10, R11: 5.1k ERJ-UP6D5101V; ERJUP6
R5, R6, R9: 1.5k RCC04021K50FKED; RCC0402_e3
U1, U2, U6: ESP32-C3; QFN32_5X5_EXP
U4: HMC221BE RF Sw; RJ-6_ADI
U5: HMC221BE; RJ-6_ADI
Y2: FK4000032 Crystal; FK4000032

Connections:
GND: C1.1, C2.1, C3.1, C4.1, C5.1, C7.1, IC1.4 (GND), IC2.2 (GND), IC2.5 (VBUS), IC3.2 (GND), IC3.5 (VBUS), IC4.2 (GND), IC4.5 (VBUS), J1.A1-B12 (GND), J1.B1-A12 (GND), J2.A1-B12 (GND), J2.B1-A12 (GND), J3.A1-B12 (GND), J3.B1-A12 (GND), J4.2 (GND_1), J4.3 (GND_2), PS1.2 (GROUND), PS2.2 (GROUND), R1.1, R2.2, R7.1, R8.2, R10.1, R11.2, U1.33 (GND), U2.33 (GND), U4.2 (GND), U5.2 (GND), U6.33 (GND), Y2.2 (GROUND)
unnamed: ANT1.1 (RF_FEED), U4.3 (RF1)
unnamed: ANT2.1 (RF_FEED), U5.3 (RF1)
unnamed: C3.2, C5.2, IC1.2 (1G), IC1.6 (VDD), PS2.3 (+VOUT), R9.1, U2.2 (VDD3P3), U2.3 (VDD3P3), U2.7 (CHIP_EN), U2.17 (VDD3P3_CPU), U2.18 (VDD_SPI), U2.31 (VDDA), U2.32 (VDDA), Y2.1 (OE), Y2.4 (VDD)
unnamed: IC1.1 (CLKIN), Y2.3 (CLOCK_OUTPUT)
unnamed: IC1.3 (Y0), U6.30 (XTAL_P)
unnamed: IC1.8 (Y1), U1.30 (XTAL_P)
unnamed: IC1.5 (Y2), U2.30 (XTAL_P)
unnamed: IC2.1 (I/O1_1), J1.A6 (DP1)
unnamed: IC2.6 (I/O1_2), U1.26 (GPIO19)
unnamed: IC2.3 (I/O2_1), J1.A7 (DN1)
unnamed: IC2.4 (I/O2_2), R6.2, U1.25 (GPIO18)
unnamed: IC3.1 (I/O1_1), J2.A6 (DP1)
unnamed: IC3.6 (I/O1_2), U6.26 (GPIO19)
unnamed: IC3.3 (I/O2_1), J2.A7 (DN1)
unnamed: IC3.4 (I/O2_2), R5.2, U6.25 (GPIO18)
unnamed: IC4.1 (I/O1_1), J3.A6 (DP1)
unnamed: IC4.6 (I/O1_2), U2.26 (GPIO19)
unnamed: IC4.3 (I/O2_1), J3.A7 (DN1)
unnamed: IC4.4 (I/O2_2), R9.2, U2.25 (GPIO18)
unnamed: J1.A5 (CC1), R1.2
unnamed: J1.B5 (CC2), R8.1
unnamed: J2.A5 (CC1), R7.2
unnamed: J2.B5 (CC2), R2.1
unnamed: J3.A5 (CC1), R10.2
unnamed: J3.B5 (CC2), R11.1
unnamed: C2.2, C7.2, J4.1 (POWER), PS1.1 (+VIN), PS2.1 (+VIN)
unnamed: C1.2, C4.2, PS1.3 (+VOUT), R5.1, R6.1, U1.2 (VDD3P3), U1.3 (VDD3P3), U1.7 (CHIP_EN), U1.17 (VDD3P3_CPU), U1.18 (VDD_SPI), U1.31 (VDDA), U1.32 (VDDA), U6.2 (VDD3P3), U6.3 (VDD3P3), U6.7 (CHIP_EN), U6.17 (VDD3P3_CPU), U6.31 (VDDA), U6.32 (VDDA)
unnamed: U1.1 (LNA_IN), U4.5 (RFC)
unnamed: U2.1 (LNA_IN), U5.5 (RFC)
unnamed: U4.6 (A), U5.6 (A), U6.16 (GPIO10)
unnamed: U4.4 (B), U5.4 (B), U6.15 (GPIO9)
unnamed: U4.1 (RF2), U5.1 (RF2), U6.1 (LNA_IN)
