DhaDylan/esp32c3-direction-finding/(commit log)

2026-08-12 Initial commit: ESP32C3 WiFi direction-finding PCB project
    Includes KiCad schematic/PCB, footprints, symbols, 3D models, and design docs.
    [0603YC103M4T2A.stp, 10.28.25 V2 Wifi PCB.kicad_pcb, 10.28.25 V2 Wifi PCB.kicad_sch, 430182043816.stp, 694106301002.stp, ABM14N-40.0000MHZ-8-N1U.stp, C1608X7T1A106M080AC.stp, CDCLVC1103PW.stp]
2026-08-13 Populate missing 3D component models on the PCB
    Rewired footprint 3D model references to a project-relative path
    (../3dmodels/3dmodels/) so they resolve on any machine instead of the
    original absolute Downloads/Desktop paths. Added generic KiCad
    standard-library STEP models as visual substitutes where the exact
    manufacturer model wasn't available locally (ESP32-C3 QFN-32, PTS645
    tactile switches, 0402/0603 R/C, 0603 LED), and wired up RJ-6_ADI
    (RF switch) and USB4105-GF-A (USB-C) models that were already present
    in the repo but never referenced.
    R11 (PWR8030W1002FE power resistor) still has no 3D model available.
    [06032A101FAT2A.stp, 10.28.25 V2 Wifi PCB.kicad_pcb, LTST-C190GKT.stp, MAJCU168BB7104KTEA01.stp, MCU08050C2209FP500.stp, MHQ0402PSA2N0ST000.stp, generic_C_0603_1608Metric.stp, generic_QFN32_5x5mm.stp]
2026-08-16 Add 2x4 array prototype mockup (ESPARGOS-style)
    Visual mockup only -- 8 antennas on a 2-row x 4-column grid at exact
    lambda/2 (62.5mm) pitch in both axes, landscape 262x170mm, with a
    controller/clock/power strip along the bottom edge. 168 footprints
    placed to scale; no nets, routing, or copper pours.
    Generated by build_2x4_mockup.py rather than hand-edited, so the
    geometry constants can be adjusted and the board regenerated.
    Kept in its own directory -- the working 1x2 design in pcb/ is
    untouched and remains the reference design.
    Also adds the 3D renders of both boards to renders/.
    [2x4_array_mockup.kicad_pcb]
2026-08-16 Add CLAUDE.md project guide
    Single-file orientation for agents: the physics goal (phase-coherent CSI
    for AoA), the distinct purpose of each of the two PCB designs, and an
    explicit warning to keep them separate.
    Documents the 2x4 prototype's size (262x170mm), antenna spacing
    (62.5mm = lambda/2 both axes), and the four signal domains -- clock
    distribution, SPI CSI backhaul, RF switch control, and the shared
    calibration path.
    Open-issue list was verified against the current netlist rather than
    copied from the schematic review, so already-fixed findings are marked
    as such and won't be re-fixed.
