DhaDylan/esp32c3-direction-finding/(notices)

Notices in the files:
3dmodels/3dmodels/LTST-C190GKT.stp:
Copyright (C) 2018, kicad StepUp
This work is licensed under the [Creative Commons CC-BY-SA 4.0 License](https://creativecommons.org/licenses/by-sa/4.0/legalcode),
with the following exception:
To the extent that the creation of electronic designs that use 'Licensed Material' can be considered to be 'Adapted Material',
You are free to use the library data in your own projects without the obligation to share your project files under this or any other license agreement.
3dmodels/3dmodels/MHQ0402PSA2N0ST000.stp:
Copyright (C) 2017, kicad StepUp
3dmodels/3dmodels/generic_QFN32_5x5mm.stp:
Copyright (C) 2019, kicad StepUp
3dmodels/3dmodels/generic_SW_PTS645.stp:
Copyright (C) 2025, KiCAD
This work is licensed under the
[Creative Commons CC-BY-SA 4.0 License](https://creativecommons.org/licenses/by-sa/4.0/legalcode),
project files under this or any other license agreement. However, if you wish to distribute
